vgarcikl/Oregon-Scientific-V3-Weather-Sensor-Emulator/img/oscilator.jpg

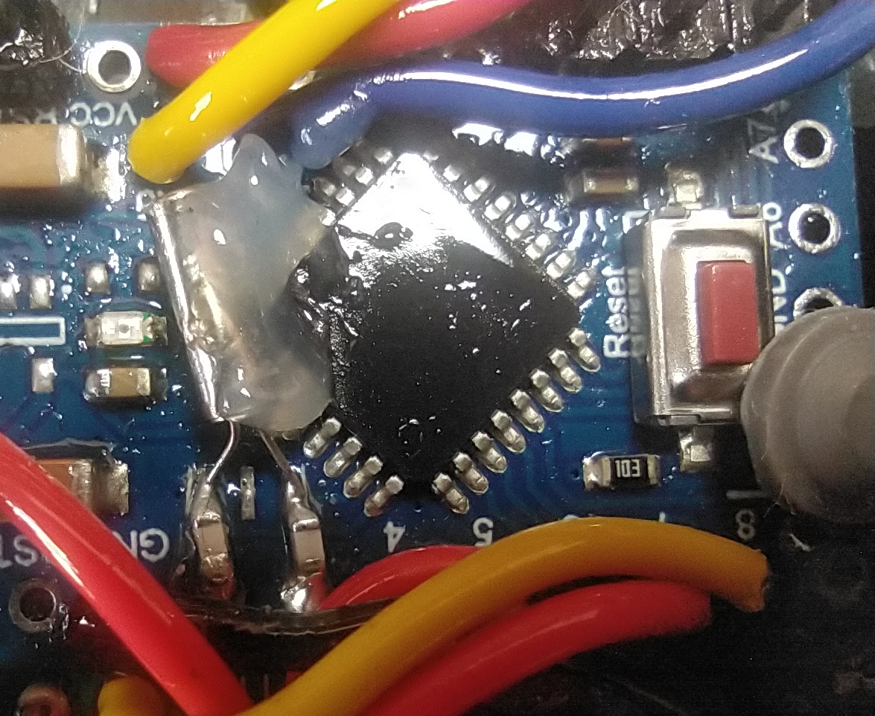
img/oscilator.jpg
