vgarcikl/Oregon-Scientific-V3-Weather-Sensor-Emulator/img/sensor-img.jpg

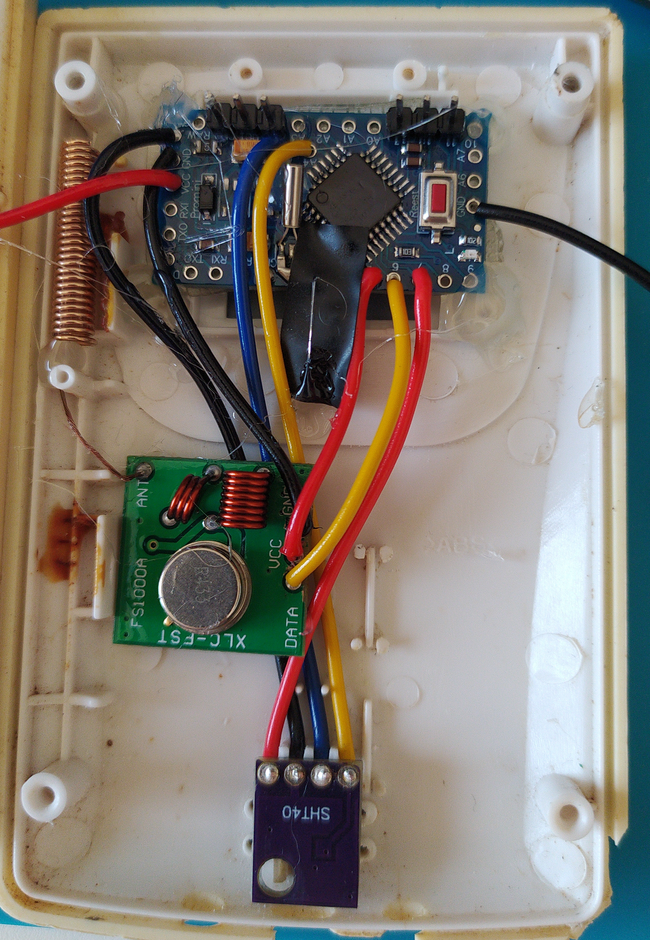
img/sensor-img.jpg
